Brain-dll/MIDDLE-ALTITUDE-BACKUP-SYSTEM-EMBEDDED-/README.md

# technofest-3000
This project are developed for model rocket competition of technofest. Main purpose is developing avionic systems
