Brain-dll/MIDDLE-ALTITUDE-BACKUP-SYSTEM-EMBEDDED-/STM32F102CBT6/REV1.0 - ERR/ATESLEME.brd

## EAGLE design STM32F102CBT6/REV1.0 - ERR/ATESLEME.brd (2021-05-29)

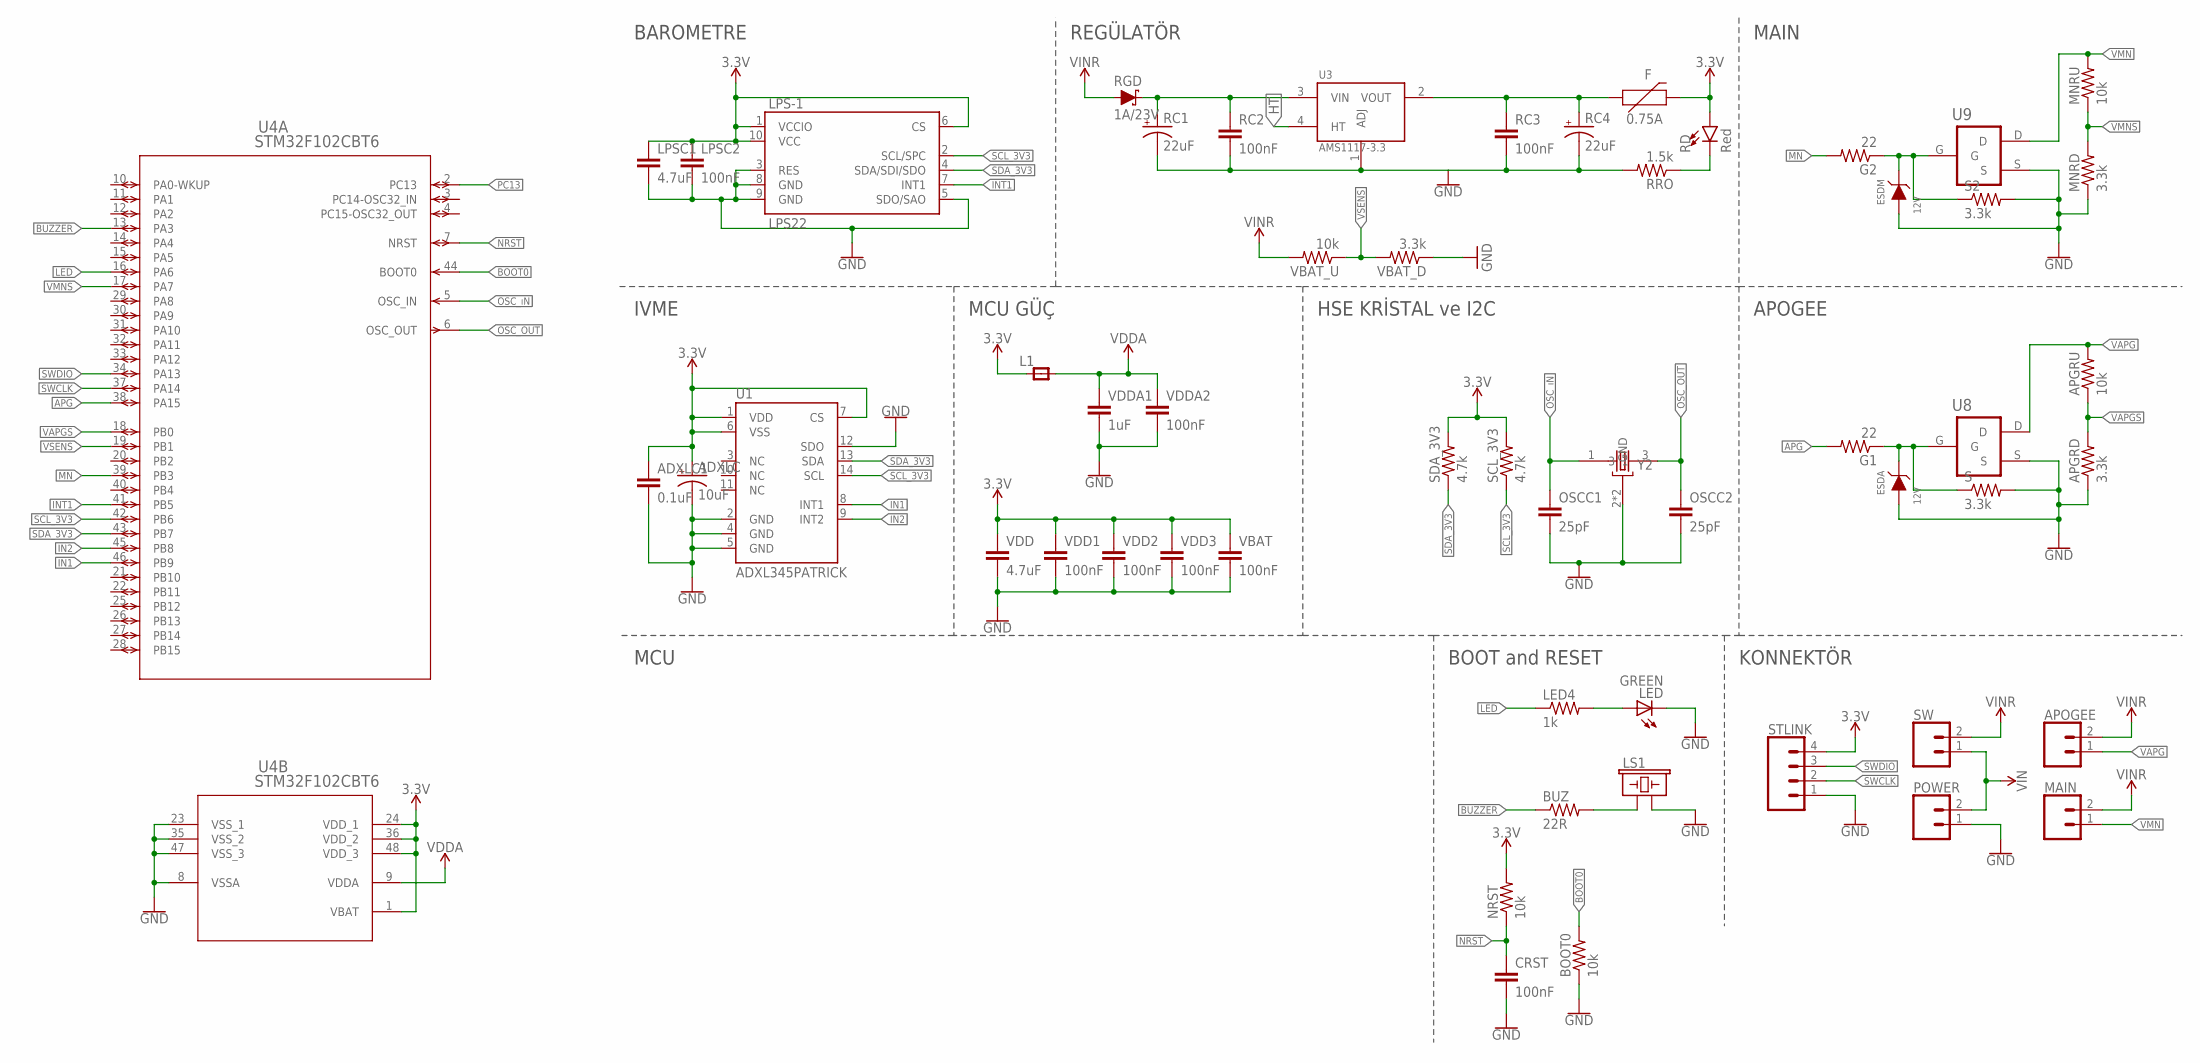
[picture p1: schematic ATESLEME.sch]

Parts:
ADXLC: 10uF; EIA3216
ADXLC1: 0.1uF; 0603
APGRD: 3.3k; 0603-RES
APGRU: 10k; 0603-RES
APOGEE: CONN_023.5MM-NO_SILK; SCREWTERMINAL-3.5MM-2-NS
BOOT0: 10k; 0603-RES
BUZ: 22R; 0603-RES
CRST: 100nF; 0603
ESDA: 12V; WE-TVSP_DO-214AC_UNIDIRECTIONAL
ESDM: 12V; WE-TVSP_DO-214AC_UNIDIRECTIONAL
F: 0.75A; 1206
G1, G2: 22; 0603-RES
L1: RC-MASTER-SMD_FB_0805MP; RC-MASTER-SMD_L0805MP
LED: GREEN; LED-0603
LED4: 1k; 0603-RES
LPS-1: LPS22; LPS22H
LPSC1: 4.7uF; 0603
LPSC2: 100nF; 0603
LS1: BUZZER-PTH; BUZZER-12MM
MAIN: CONN_023.5MM-NO_SILK; SCREWTERMINAL-3.5MM-2-NS
MNRD: 3.3k; 0603-RES
MNRU: 10k; 0603-RES
NRST: 10k; 0603-RES
OSCC1, OSCC2: 25pF; 0603
POWER: CONN_023.5MM-NO_SILK; SCREWTERMINAL-3.5MM-2-NS
RC1, RC4: 22uF; EIA3528
RC2, RC3: 100nF; 0603
RD: Red; LED-0603
RGD: 1A/23V; SOD-323
RRO: 1.5k; 0603-RES
S, S2: 3.3k; 0603-RES
SCL_3V3: 4.7k; 0603-RES
SDA_3V3: 4.7k; 0603-RES
STLINK: CONN_04; 1X04
SW: CONN_023.5MM-NO_SILK; SCREWTERMINAL-3.5MM-2-NS
U1: ADXL345PATRICK; LGA14_1:1_PATRICK
U3: AMS1117-3.3; SOT229P700X180-4N
U4: STM32F102CBT6; LQFP48-7X7MM
U8, U9: IRLML6344TRPBF; SOT95P240X112-3N
VBAT: 100nF; 0603
VBAT_D: 3.3k; 0603-RES
VBAT_U: 10k; 0603-RES
VDD: 4.7uF; 0603
VDD1, VDD2, VDD3: 100nF; 0603
VDDA1: 1uF; 0603
VDDA2: 100nF; 0603
Y2: ABM2B-8.000MHZ-10-1-U-T; OSCCC500X320X110-4N

Connections:
3.3V: ADXLC.+, ADXLC1.1, F.2, L1.1, LPS-1.1 (VCCIO), LPS-1.6 (CS), LPS-1.10 (VCC), LPSC1.1, LPSC2.1, NRST.2, RD.A, SCL_3V3.2, SDA_3V3.2, STLINK.4, U1.1 (VDD), U1.6 (VSS), U1.7 (CS), U4.1 (VBAT), U4.24 (VDD_1), U4.36 (VDD_2), U4.48 (VDD_3), VBAT.1, VDD.1, VDD1.1, VDD2.1, VDD3.1
APG: G1.2, U4.38 (PA15)
BOOT0: BOOT0.2, U4.44 (BOOT0)
BUZZER: BUZ.1, U4.13 (PA3)
GND: ADXLC.-, ADXLC1.2, APGRD.1, BOOT0.1, CRST.2, ESDA.2 (A), ESDM.2 (A), LED.C, LPS-1.3 (RES), LPS-1.5 (SDO/SAO), LPS-1.8 (GND), LPS-1.9 (GND), LPSC1.2, LPSC2.2, LS1.- (2), MNRD.1, OSCC1.2, OSCC2.2, POWER.1, RC1.C (-), RC2.2, RC3.2, RC4.C (-), RRO.2, S.2, S2.2, STLINK.1, U1.2 (GND), U1.4 (GND), U1.5 (GND), U1.12 (SDO), U3.1 (ADJ), U4.8 (VSSA), U4.23 (VSS_1), U4.35 (VSS_2), U4.47 (VSS_3), U8.S, U9.S, VBAT.2, VBAT_D.1, VDD.2, VDD1.2, VDD2.2, VDD3.2, VDDA1.2, VDDA2.2, Y2.2 (GND), Y2.4 (GND)
HT: U3.4 (HT)
IN1: U1.8 (INT1), U4.46 (PB9)
IN2: U1.9 (INT2), U4.45 (PB8)
INT1: LPS-1.7 (INT1), U4.41 (PB5)
LED: LED4.1, U4.16 (PA6)
MN: G2.2, U4.39 (PB3)
unnamed: F.1, RC3.1, RC4.A (+), U3.2 (VOUT)
unnamed: RD.C, RRO.1
unnamed: ESDM.1 (C), G2.1, S2.1, U9.G
unnamed: LED.A, LED4.2
unnamed: BUZ.2, LS1.+ (1)
unnamed: ESDA.1 (C), G1.1, S.1, U8.G
NRST: CRST.1, NRST.1, U4.7 (NRST)
OSC_OUT: OSCC2.1, U4.6 (OSC_OUT), Y2.3
OSC_ıN: OSCC1.1, U4.5 (OSC_IN), Y2.1
PC13: U4.2 (PC13)
SCL_3V3: LPS-1.2 (SCL/SPC), SCL_3V3.1, U1.14 (SCL), U4.42 (PB6)
SDA_3V3: LPS-1.4 (SDA/SDI/SDO), SDA_3V3.1, U1.13 (SDA), U4.43 (PB7)
SWCLK: STLINK.2, U4.37 (PA14)
SWDIO: STLINK.3, U4.34 (PA13)
VAPG: APGRU.2, APOGEE.1, U8.D
VAPGS: APGRD.2, APGRU.1, U4.18 (PB0)
VCC: POWER.2, SW.1
VDDA: L1.2, U4.9 (VDDA), VDDA1.1, VDDA2.1
VIN: APOGEE.2, MAIN.2, RGD.A, SW.2, VBAT_U.2
VMN: MAIN.1, MNRU.2, U9.D
VMNS: MNRD.2, MNRU.1, U4.17 (PA7)
VNR: RC1.A (+), RC2.1, RGD.C, U3.3 (VIN)
VSENS: U4.19 (PB1), VBAT_D.2, VBAT_U.1

Notes on the sheet:
BAROMETRE
KONNEKTÖR
IVME
HSE KRİSTAL ve I2C
MCU
REGÜLATÖR
MAIN
MCU GÜÇ
BOOT and RESET
APOGEE

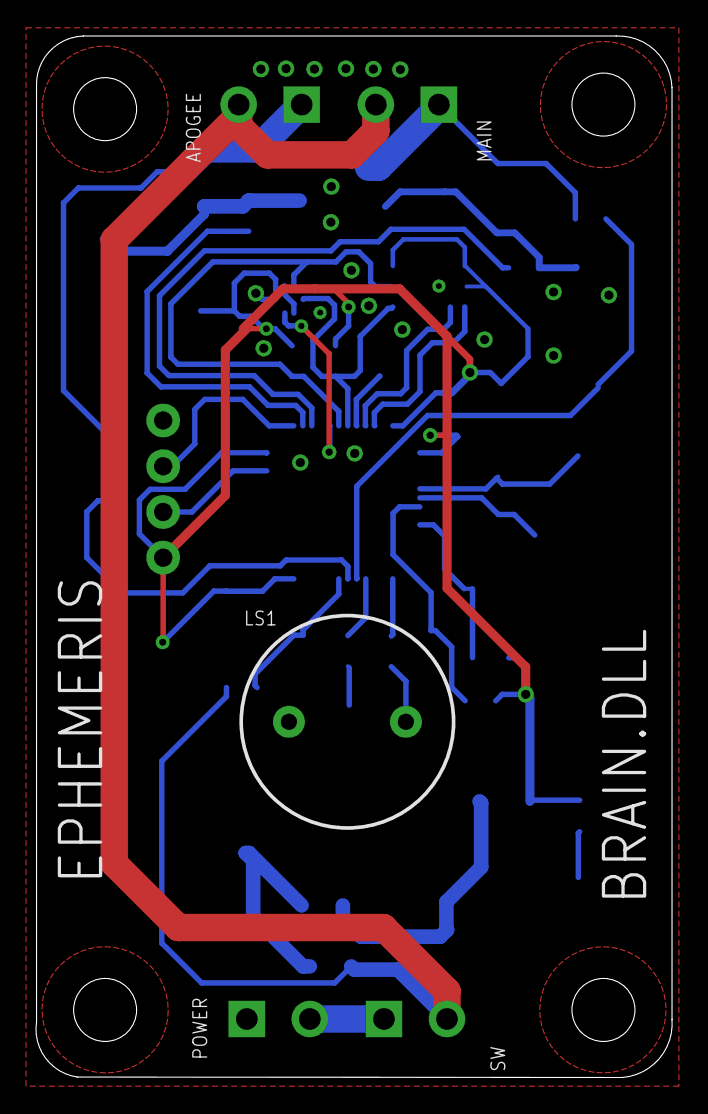
[picture p2: board ATESLEME.brd from above]

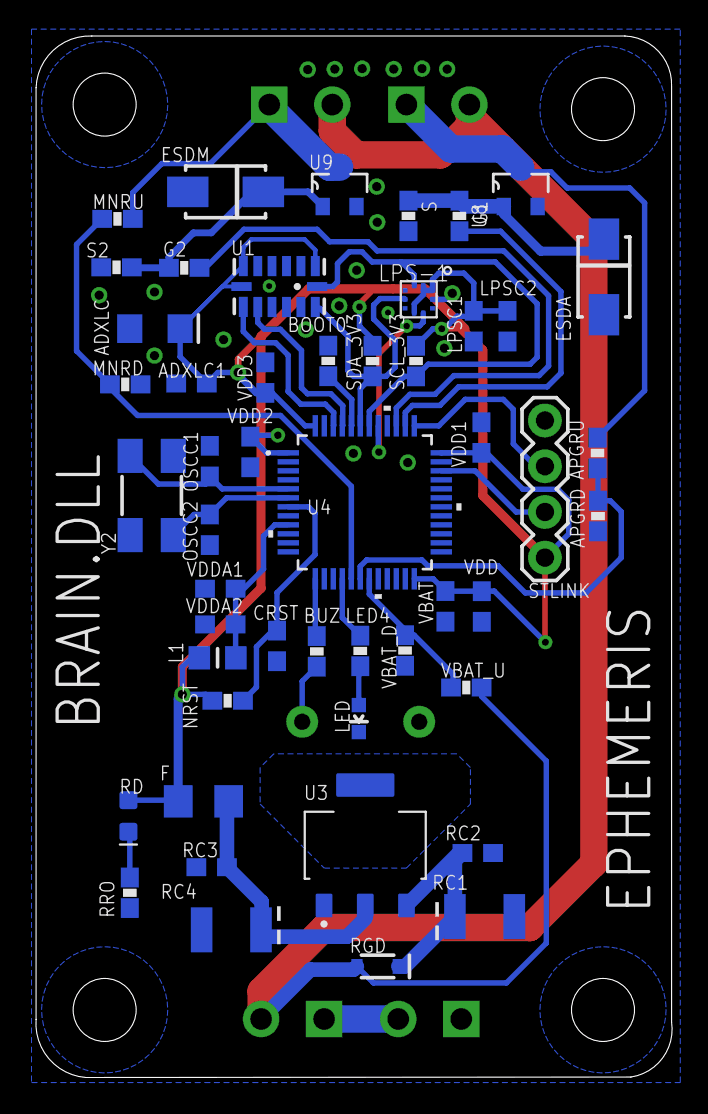
[picture p3: board ATESLEME.brd from below]

Board: 2 copper layers, 35.3 x 57.9 mm, 55 parts (50 on the bottom side), 32 nets.
