Brain-dll/MIDDLE-ALTITUDE-BACKUP-SYSTEM-EMBEDDED-/SOFTWARE/Core/Src/main.c

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
/* Includes ------------------------------------------------------------------*/
#include "main.h"

/* USER CODE BEGIN Includes */
#include "ADXL345.h"
#include "MS5611.h"
/* USER CODE END Includes */

/* USER CODE BEGIN PTD */
#define ACC_l 2.5  // kalkisi anlamak icin gerekli ivme eşigi (pozitif olmali)***

float ADXL_Z[6] = {0}, MS_V[6] = {0}, MS_A[6] = {0};
float temp, press, MS[2];
uint8_t ADXL = 0, ADXL_S = 0, MS5611 = 0, MS_S = 0, ACC_FAIL = 0, final = 0, k = 0;
uint32_t tim1 = 0, tim2 = 0, dif = 0, alt_l = 0;
/* USER CODE END PTD */

ADC_HandleTypeDef hadc1;

I2C_HandleTypeDef hi2c1;

TIM_HandleTypeDef htim2;
TIM_HandleTypeDef htim3;
TIM_HandleTypeDef htim4;

void SystemClock_Config(void);
static void MX_GPIO_Init(void);
static void MX_I2C1_Init(void);
static void MX_TIM2_Init(void);
static void MX_TIM3_Init(void);
static void MX_TIM4_Init(void);
static void MX_ADC1_Init(void);
/**
  * @brief  The application entry point.
  * @retval int
  */
int main(void)
{
  /* MCU Configuration--------------------------------------------------------*/

  /* Reset of all peripherals, Initializes the Flash interface and the Systick. */
  HAL_Init();

  /* Configure the system clock */
  SystemClock_Config();

  /* Initialize all configured peripherals */
  MX_GPIO_Init();
  MX_I2C1_Init();
  MX_TIM2_Init();
  MX_TIM3_Init();
  MX_TIM4_Init();
  MX_ADC1_Init();
  /* USER CODE BEGIN 2 */
  Scan_I2C();
  ADXL345_Init();
  MS5611_Init();
  //HAL_TIM_Base_Start(&htim3);
  enum rocket {Rail, Launch, Burnout, Apogee, Descent, Main, Recovery};
  enum rocket EPHEMERISH;


  for (uint8_t i = 0 ; i < 12 ; i++)
    {
  	  HAL_GPIO_TogglePin(GPIOA, GPIO_PIN_6);
  	  HAL_GPIO_TogglePin(GPIOA, GPIO_PIN_3);
  	  HAL_GPIO_TogglePin(GPIOB, GPIO_PIN_4);
  	  HAL_Delay(50);
    }

	if (ACC_FAIL == 0) {
		EPHEMERISH = Rail;
		HAL_TIM_Base_Start_IT(&htim2);
		//EPHEMERISH = Burnout;
	} else if (ACC_FAIL == 1) {
		EPHEMERISH = Launch;
		HAL_TIM_Base_Stop_IT(&htim2);
		HAL_TIM_Base_Start_IT(&htim3);
		HAL_TIM_Base_Start(&htim4);
	}

  /* USER CODE END 2 */

  /* Infinite loop */
  /* USER CODE BEGIN WHILE */
	while (1) {
		/* USER CODE END WHILE */

		/* USER CODE BEGIN 3 */
		switch (EPHEMERISH) {
		case Rail:
			if (ADXL == 1) {
				ADXL_Z[ADXL_S] = ADXL345_Zaxiss_filter();
				if (ADXL_S == 5) {
					uint8_t C2 = 0;
					for (uint8_t i = 0; i <= ADXL_S; i++) {
						if (ADXL_Z[i] < (-1 * ACC_l) || ADXL_Z[i] > ACC_l)
							C2++;
					}
					if (C2 >= 3) {
						EPHEMERISH = Launch;
						//EPHEMERISH = Apogee;
						HAL_TIM_Base_Stop_IT(&htim2);
						for (uint8_t i = 0; i < (EPHEMERISH * 2); i++) {
							HAL_GPIO_TogglePin(GPIOA, GPIO_PIN_3);
							HAL_Delay(50);
						}
						HAL_TIM_Base_Start_IT(&htim3);
						HAL_TIM_Base_Start(&htim4);
					}
					ADXL_S = 0;
				}
				ADXL_S++;
				ADXL = 0;
			}
			break;
		case Launch:
			if (MS5611 == 1) {
				if (alt_l == 0) {
					tim1 = __HAL_TIM_GET_COUNTER(&htim4);
					MS[0] = MS5611_ReadMedian_Altitude();
					alt_l = 1;
				} else if (alt_l == 1) {
					tim2 = __HAL_TIM_GET_COUNTER(&htim4);
					MS[1] = MS5611_ReadMedian_Altitude();
					if (tim2 < tim1) {
						tim2 = tim2 + 65535;
						dif = tim2 - tim1;
					} else
						dif = tim2 - tim1;
					MS_V[MS_S] = (MS[1] - MS[0]) / (0.001 * dif);
					if (MS_S == 5) {
						uint8_t M = 0;
						for (uint8_t i = 0; i <= MS_S; i++) {
							if (MS_V[i] > 15)  // TEST BURNOUT VALUE = 15 REAL BURNOUT VALUE = 100
								M++;
						}
						if (M >= 3) {
							//**********************
							EPHEMERISH = Burnout;
							for (uint8_t i = 0; i < (EPHEMERISH * 2); i++) {
								HAL_GPIO_TogglePin(GPIOA, GPIO_PIN_3);
								HAL_Delay(50);
							}
						}
						for (uint8_t k = 0; k <= 5; k++)
							MS_V[k] = 0;
						MS_S = 0;
					}
					MS_S++;
					alt_l = 0;
				}
				MS5611 = 0;
			}
			break;
		case Burnout:
			if (MS5611 == 1) {
				if (alt_l == 0) {
					tim1 = __HAL_TIM_GET_COUNTER(&htim4);
					MS[0] = MS5611_ReadMedian_Altitude();
					alt_l = 1;
				} else if (alt_l == 1) {
					tim2 = __HAL_TIM_GET_COUNTER(&htim4);
					MS[1] = MS5611_ReadMedian_Altitude();
					if (tim2 < tim1) {
						tim2 = tim2 + 65535;
						dif = tim2 - tim1;
					} else
						dif = tim2 - tim1;
					MS_V[MS_S] = (MS[1] - MS[0]) / (0.001 * dif);
					if (MS_S == 5) {
						uint8_t M = 0;
						for (uint8_t i = 0; i <= MS_S; i++) {
							if (MS_V[i] < 0)   // APOGEE velocity limit
								M++;
						}
						if (M >= 3) {
							EPHEMERISH = Apogee;
							HAL_TIM_Base_Stop_IT(&htim3);
							for (uint8_t i = 0; i < (EPHEMERISH * 2); i++) {
								HAL_GPIO_TogglePin(GPIOA, GPIO_PIN_3);
								HAL_Delay(50);
							}
						}
						for (uint8_t k = 0 ; k <= 5 ; k++)
							MS_V[k] = 0;
						MS_S = 0;
					}
					MS_S++;
					alt_l = 0;
				}
				MS5611 = 0;
			}
			break;
		case Apogee:
			//EPHEMERISH = Recovery;
			EPHEMERISH = Descent;
			for (uint8_t i = 0; i < (EPHEMERISH * 2); i++) {
				HAL_GPIO_TogglePin(GPIOA, GPIO_PIN_3);
				HAL_Delay(50);
			}
			HAL_GPIO_TogglePin(GPIOA, GPIO_PIN_3);
			HAL_GPIO_WritePin(GPIOA, GPIO_PIN_15, SET);
			//HAL_GPIO_WritePin(GPIOB, GPIO_PIN_3, SET);  // ***************
			HAL_Delay(600);
			HAL_GPIO_WritePin(GPIOA, GPIO_PIN_15, RESET);
			//HAL_GPIO_WritePin(GPIOB, GPIO_PIN_3, RESET);  // **************
			HAL_GPIO_TogglePin(GPIOA, GPIO_PIN_3);
			HAL_TIM_Base_Start_IT(&htim3);
			break;
		case Descent:
			if (MS5611 == 1) {
				MS_A[MS_S] = MS5611_ReadMedian_Altitude();
				if (MS_S == 5) {
					uint8_t M = 0;
					for (uint8_t i = 0; i <= MS_S; i++) {
						if (MS_A[i] < 500)
							M++;
					}
					if (M >= 3) {
						// MAIN FIRE
						EPHEMERISH = Main;
						HAL_TIM_Base_Stop_IT(&htim3);
						for (uint8_t i = 0; i < (EPHEMERISH * 2); i++) {
							HAL_GPIO_TogglePin(GPIOA, GPIO_PIN_3);
							HAL_Delay(50);
						}
					}
					for (uint8_t k = 0 ; k <= 5 ; k++)
						MS_A[k] = 0;
					MS_S = 0;
				}
				MS_S++;
				MS5611 = 0;
			}
			break;
		case Main:
			EPHEMERISH = Recovery;
			for (uint8_t i = 0; i < (EPHEMERISH * 2); i++) {
				HAL_GPIO_TogglePin(GPIOA, GPIO_PIN_3);
				HAL_Delay(50);
			}
			HAL_GPIO_WritePin(GPIOA, GPIO_PIN_3, SET);
			HAL_GPIO_WritePin(GPIOB, GPIO_PIN_3, SET);
			HAL_Delay(600);
			HAL_GPIO_WritePin(GPIOB, GPIO_PIN_3, RESET);
			HAL_GPIO_WritePin(GPIOA, GPIO_PIN_3, RESET);
			break;
		case Recovery:
			for (uint8_t i = 0; i < (EPHEMERISH * 2); i++) {
				HAL_GPIO_TogglePin(GPIOB, GPIO_PIN_4);
				HAL_Delay(500);
				final++;
			}
			break;
		}
	}
/* USER CODE END 3 */
}

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
/* USER CODE BEGIN 4 */
void Scan_I2C(void){
	for(uint8_t i = 0; i < 255 ; i++){
		if(HAL_I2C_IsDeviceReady(&hi2c1, i, 1, 10) == HAL_OK){
			k++;
		}
	}
}
/* USER CODE END 4 */
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
