Brain-dll/MIDDLE-ALTITUDE-BACKUP-SYSTEM-EMBEDDED-/SOFTWARE/Core/Inc/main.h

#define BUZZER_Pin GPIO_PIN_3
#define BUZZER_GPIO_Port GPIOA
#define BOTTOM_LED_Pin GPIO_PIN_6
#define BOTTOM_LED_GPIO_Port GPIOA
#define VSENS_Pin GPIO_PIN_1
#define VSENS_GPIO_Port GPIOB
#define APOGEE_Pin GPIO_PIN_15
#define APOGEE_GPIO_Port GPIOA
#define MAIN_Pin GPIO_PIN_3
#define MAIN_GPIO_Port GPIOB
#define TOP_LED_Pin GPIO_PIN_4
#define TOP_LED_GPIO_Port GPIOB
