Brain-dll/MIDDLE-ALTITUDE-BACKUP-SYSTEM-EMBEDDED-/(commit log)

2021-02-27 Ignition computer was comleted and cad file was builed
    [ATESLEME.brd, ATESLEME.sch]
2021-02-28 Guard ring was located around of HSE crystal
    [ATESLEME.brd]
2021-03-03 Discrite polygon was applied to heat pad of AMS1117-3.3
    [ATESLEME.brd, ATESLEME.sch]
2021-03-05 Some vias was putted near the sources of NMOS's
    [ATESLEME.brd]
2021-03-06 Drill size maken 20 diameter
    [ATESLEME.brd]
2021-03-08 Telemetry V1.0.0 was completed
    [ATESLEME.sch, Mergen Telemetri + Ateşleme.brd, Mergen Telemetri + Ateşleme.sch]
2021-03-08 Telemetry system was moved to new repository
    [Mergen Telemetri + Ateşleme.brd, Mergen Telemetri + Ateşleme.sch]
2021-03-08 some modification was maken on the routes
    [ATESLEME.brd]
2021-03-10 Routes are be extended
    [ATESLEME.brd]
2021-03-10 LOGO was uploaded
    [ATESLEME.brd, ATESLEME.sch]
2021-03-14 Extra polygon was added for methal distance
    [ATESLEME.brd]
2021-03-24 Redesign was maken for ignition
    [ATESLEME.brd, ATESLEME.sch]
2021-03-26 New version of boards with new controller was designed
    [ATESLEME.brd, ATESLEME.sch, LQFP48-7x7mm.step]
2021-03-28 Preparing for first order
    [ATESLEME.brd]
2021-04-03 Polygon witdh was increased IMPORTANT
    [ATESLEME.brd, ATESLEME.sch]
2021-04-03 Polygon 15 mils
    [ATESLEME.brd]
2021-04-06 NMOS trace was be expanded and 1206 package version was created
    [ATESLEME.brd, ATESLEME.sch]
2021-04-08 packages was modified according to stock situation
    [ATESLEME.brd, ATESLEME.sch]
2021-04-19 Some modification was done
    [ATESLEME.brd]
2021-05-29 Revision V2.0.0 was released
    [ATESLEME.brd, ATESLEME.sch]
2021-06-02 Version 2.0 was updated by brain.dll
    [ATESLEME.brd, ATESLEME.sch]
2021-06-30 VDDA cap calue was changed
    [ATESLEME.brd, ATESLEME.sch]
2021-07-05 Regulator was added for e match and released new two version for ordering
    [ATESLEME.brd, ATESLEME.sch]
2021-08-08 Sotware and Algorithm was added
    [ATESLEME.brd, ATESLEME.sch]
2021-09-17 Unneccessary file was deleted
    [ATESLEME.brd, ATESLEME.sch, LQFP48-7x7mm.step]
